light-tech/crazyflie1-electronics/ecad/Crazyflie contol board.kicad_sch

## KiCad design ecad/Crazyflie contol board.kicad_sch (2025-04-17)

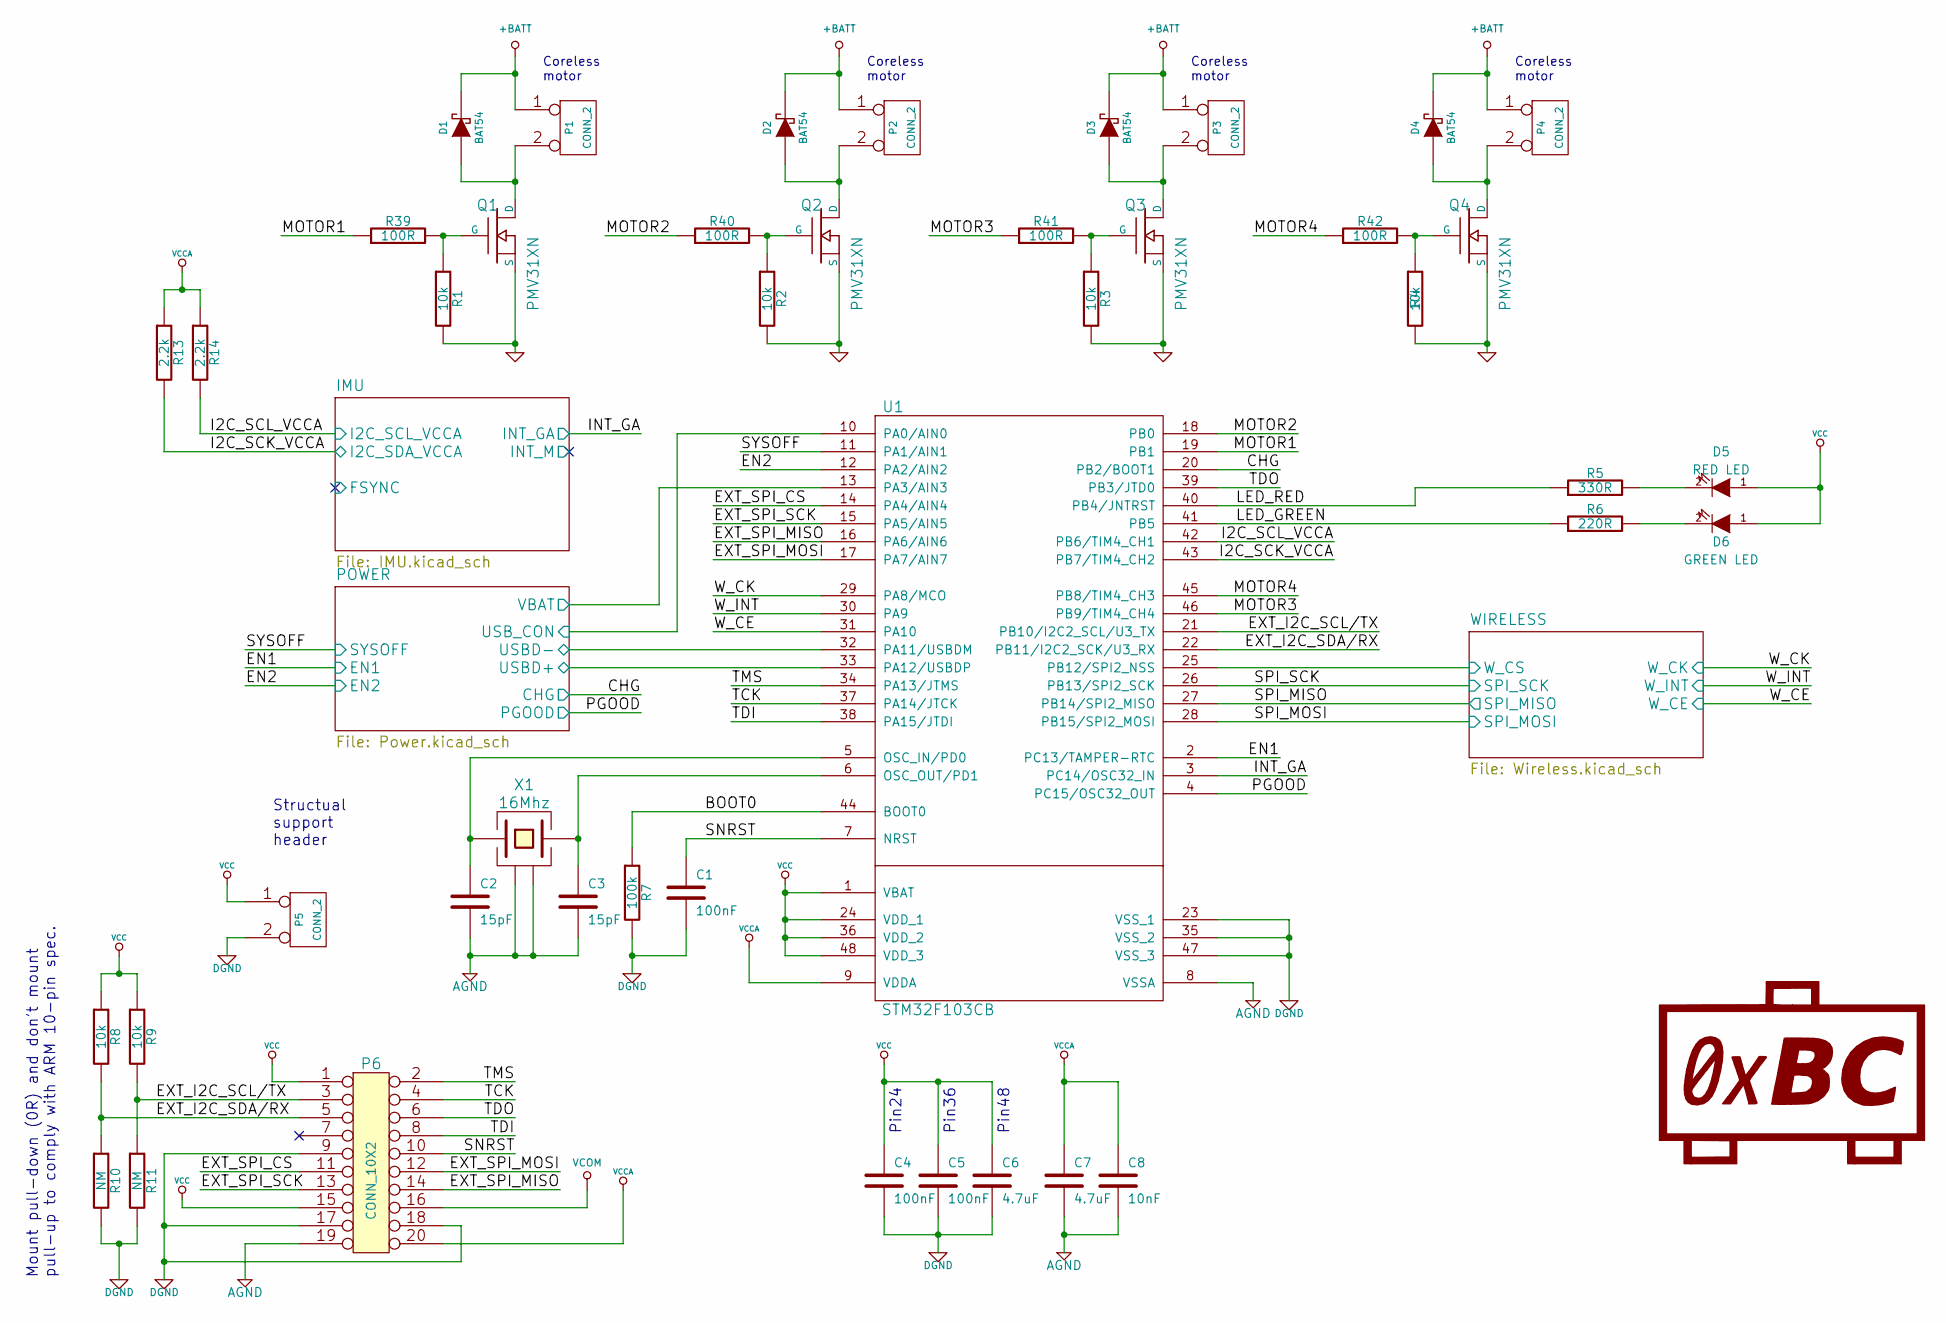
[picture p1: schematic Crazyflie contol board.kicad_sch]

Parts:
C1, C4, C5: 100nF; SM0603_Capa
C2, C3: 15pF; SM0603_Capa
C6, C7: 4.7uF; SM0603_Capa
C8: 10nF; SM0603_Capa
D1, D2, D3, D4: BAT54; SOD323
D5: RED LED; SMDLED-0603
D6: GREEN LED; SMDLED-0603
P1, P2, P3, P4, P5: CONN_2; PINHEADER_127_2X1
P6: CONN_10X2; PINHEADER_127_2X10
Q1, Q2, Q3, Q4: PMV31XN; SOT23GDS
R1, R2, R3, R4: 10k; SM0402
R5: 330R; SM0603
R6: 220R; SM0603
R7: 100k; SM0603
R8, R9: 10k; SM0603
R10, R11: NM; SM0603
R13, R14: 2.2k; SM0603
R39, R40, R41, R42: 100R; SM0402
U1: STM32F103CB; LQFP-48
X1: 16Mhz; XTAL-5.0x3.2

Connections:
+BATT: D1.2 (K), D2.2 (K), D3.2 (K), D4.2 (K), P1.1, P2.1, P3.1, P4.1
AGND: C2.2, C3.2, C7.2, C8.2, P6.19, U1.8 (VSSA), X1.2 (GND), X1.4 (GND)
BOOT0: R7.1, U1.44 (BOOT0)
CHG: U1.20 (PB2/BOOT1)
DGND: C1.2, C4.2, C5.2, C6.2, P5.2 (PM), P6.9, P6.17, P6.18, R7.2, R10.2, R11.2, U1.23 (VSS_1), U1.35 (VSS_2), U1.47 (VSS_3)
EN1: U1.2 (PC13/TAMPER-RTC)
EN2: U1.12 (PA2/AIN2)
EXT_I2C_SCL/TX: P6.3, R9.2, R11.1, U1.21 (PB10/I2C2_SCL/U3_TX)
EXT_I2C_SDA/RX: P6.5, R8.2, R10.1, U1.22 (PB11/I2C2_SCK/U3_RX)
EXT_SPI_CS: P6.11, U1.14 (PA4/AIN4)
EXT_SPI_MISO: P6.14, U1.16 (PA6/AIN6)
EXT_SPI_MOSI: P6.12, U1.17 (PA7/AIN7)
EXT_SPI_SCK: P6.13, U1.15 (PA5/AIN5)
GND: Q1.S, Q2.S, Q3.S, Q4.S, R1.2, R2.2, R3.2, R4.2
I2C_SCK_VCCA: R13.2, U1.43 (PB7/TIM4_CH2)
I2C_SCL_VCCA: R14.2, U1.42 (PB6/TIM4_CH1)
INT_GA: U1.3 (PC14/OSC32_IN)
LED_GREEN: R6.1, U1.41 (PB5)
LED_RED: R5.1, U1.40 (PB4/JNTRST)
MOTOR1: R39.1, U1.19 (PB1)
MOTOR2: R40.1, U1.18 (PB0)
MOTOR3: R41.1, U1.46 (PB9/TIM4_CH4)
MOTOR4: R42.1, U1.45 (PB8/TIM4_CH3)
unnamed: C2.1, U1.5 (OSC_IN/PD0), X1.1
unnamed: C3.1, U1.6 (OSC_OUT/PD1), X1.3
unnamed: D1.1 (A), P1.2 (PM), Q1.D
unnamed: D2.1 (A), P2.2 (PM), Q2.D
unnamed: D3.1 (A), P3.2 (PM), Q3.D
unnamed: D4.1 (A), P4.2 (PM), Q4.D
unnamed: D5.2 (K), R5.2
unnamed: D6.2 (K), R6.2
unnamed: Q1.G, R1.1, R39.2
unnamed: Q2.G, R2.1, R40.2
unnamed: Q3.G, R3.1, R41.2
unnamed: Q4.G, R4.1, R42.2
PGOOD: U1.4 (PC15/OSC32_OUT)
SNRST: C1.1, P6.10, U1.7 (NRST)
SPI_MISO: U1.27 (PB14/SPI2_MISO)
SPI_MOSI: U1.28 (PB15/SPI2_MOSI)
SPI_SCK: U1.26 (PB13/SPI2_SCK)
SYSOFF: U1.11 (PA1/AIN1)
TCK: P6.4, U1.37 (PA14/JTCK)
TDI: P6.8, U1.38 (PA15/JTDI)
TDO: P6.6, U1.39 (PB3/JTD0)
TMS: P6.2, U1.34 (PA13/JTMS)
USBD+: U1.33 (PA12/USBDP)
USBD-: U1.32 (PA11/USBDM)
USB_CON: U1.10 (PA0/AIN0)
VBAT: U1.13 (PA3/AIN3)
VCC: C4.1, C5.1, C6.1, D5.1 (A), D6.1 (A), P5.1, P6.1, P6.15, R8.1, R9.1, U1.1 (VBAT), U1.24 (VDD_1), U1.36 (VDD_2), U1.48 (VDD_3)
VCCA: C7.1, C8.1, P6.20, R13.1, R14.1, U1.9 (VDDA)
VCOM: P6.16
W_CE: U1.31 (PA10)
W_CK: U1.29 (PA8/MCO)
W_CS: U1.25 (PB12/SPI2_NSS)
W_INT: U1.30 (PA9)

Notes on the sheet:
Coreless motor
Pin24
Structual support header
Mount pull-down (0R) and don't mount pull-up to comply with ARM 10-pin spec.
Pin48
Pin36
