light-tech/crazyflie1-electronics/ecad/IMU.kicad_sch

## KiCad design ecad/IMU.kicad_sch (2025-04-17)

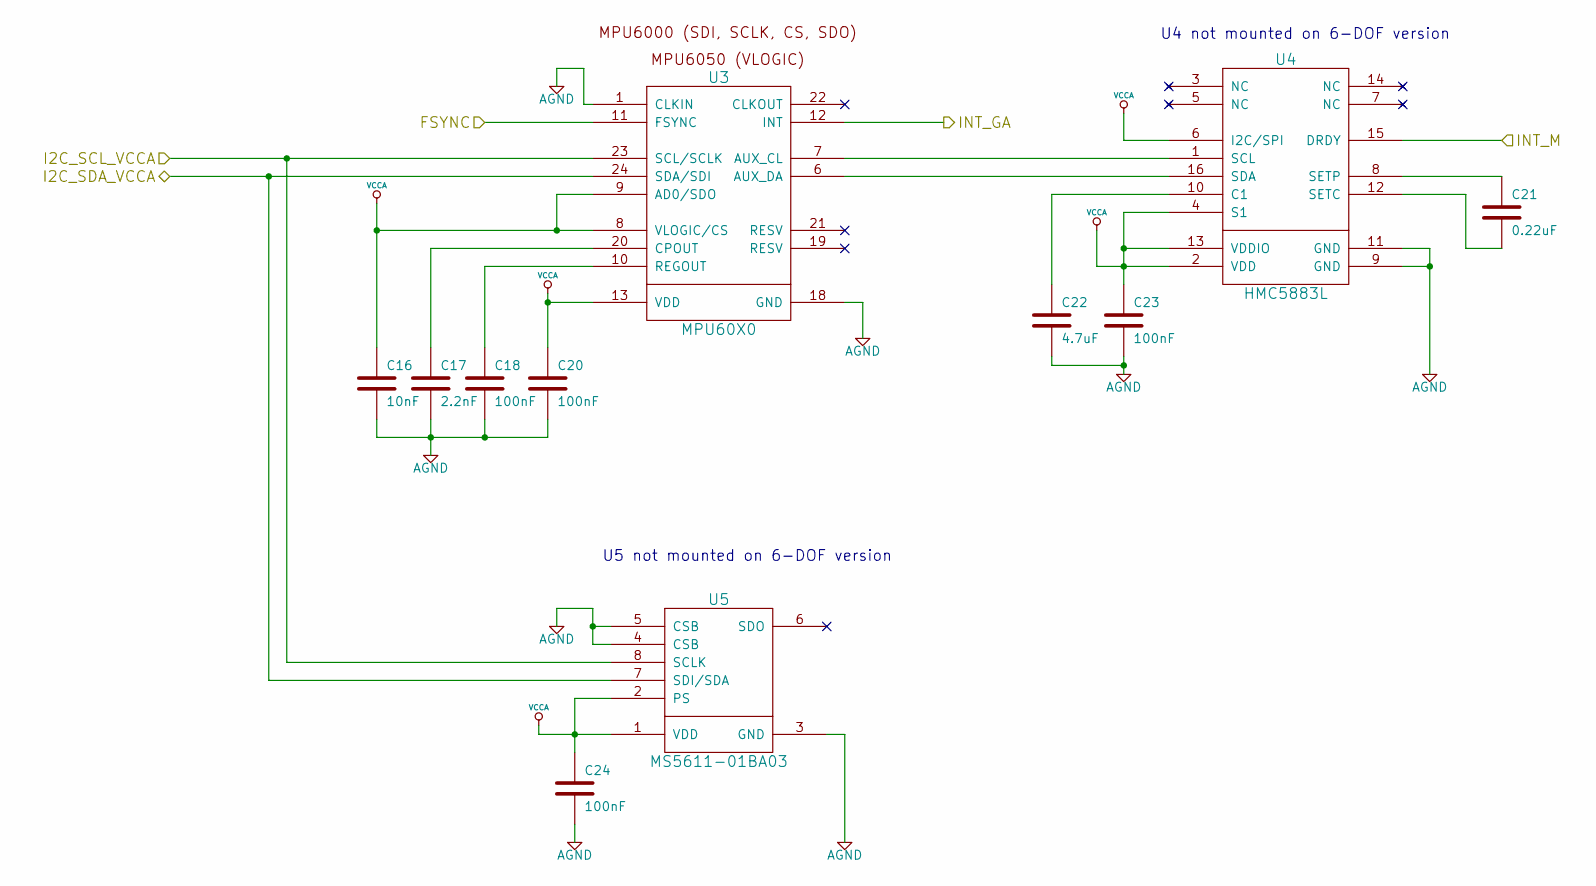
[picture p2: schematic IMU.kicad_sch]

Parts:
C16: 10nF; SM0603_Capa
C17: 2.2nF; SM0603_Capa
C18, C20, C23, C24: 100nF; SM0603_Capa
C21: 0.22uF; SM0603_Capa
C22: 4.7uF; SM0603_Capa
U3: MPU60X0
U4: HMC5883L; QFN16_HMC5883L
U5: MS5611-01BA03; MS5611

Connections:
AGND: C16.2, C17.2, C18.2, C20.2, C22.2, C23.2, C24.2, U3.1 (CLKIN), U3.18 (GND), U4.9 (GND), U4.11 (GND), U5.3 (GND), U5.4 (CSB), U5.5 (CSB)
FSYNC: U3.11 (FSYNC)
I2C_SCL_VCCA: U3.23 (SCL/SCLK), U5.8 (SCLK)
I2C_SDA_VCCA: U3.24 (SDA/SDI), U5.7 (SDI/SDA)
INT_GA: U3.12 (INT)
INT_M: U4.15 (DRDY)
unnamed: C17.1, U3.20 (CPOUT)
unnamed: C18.1, U3.10 (REGOUT)
unnamed: C21.1, U4.8 (SETP)
unnamed: C21.2, U4.12 (SETC)
unnamed: C22.1, U4.10 (C1)
unnamed: U3.6 (AUX_DA), U4.16 (SDA)
unnamed: U3.7 (AUX_CL), U4.1 (SCL)
VCCA: C16.1, C20.1, C23.1, C24.1, U3.8 (VLOGIC/CS), U3.9 (AD0/SDO), U3.13 (VDD), U4.2 (VDD), U4.4 (S1), U4.6 (I2C/SPI), U4.13 (VDDIO), U5.1 (VDD), U5.2 (PS)

Notes on the sheet:
U4 not mounted on 6-DOF version
U5 not mounted on 6-DOF version
