light-tech/crazyflie1-electronics/ecad/Power.kicad_sch

## KiCad design ecad/Power.kicad_sch (2025-04-17)

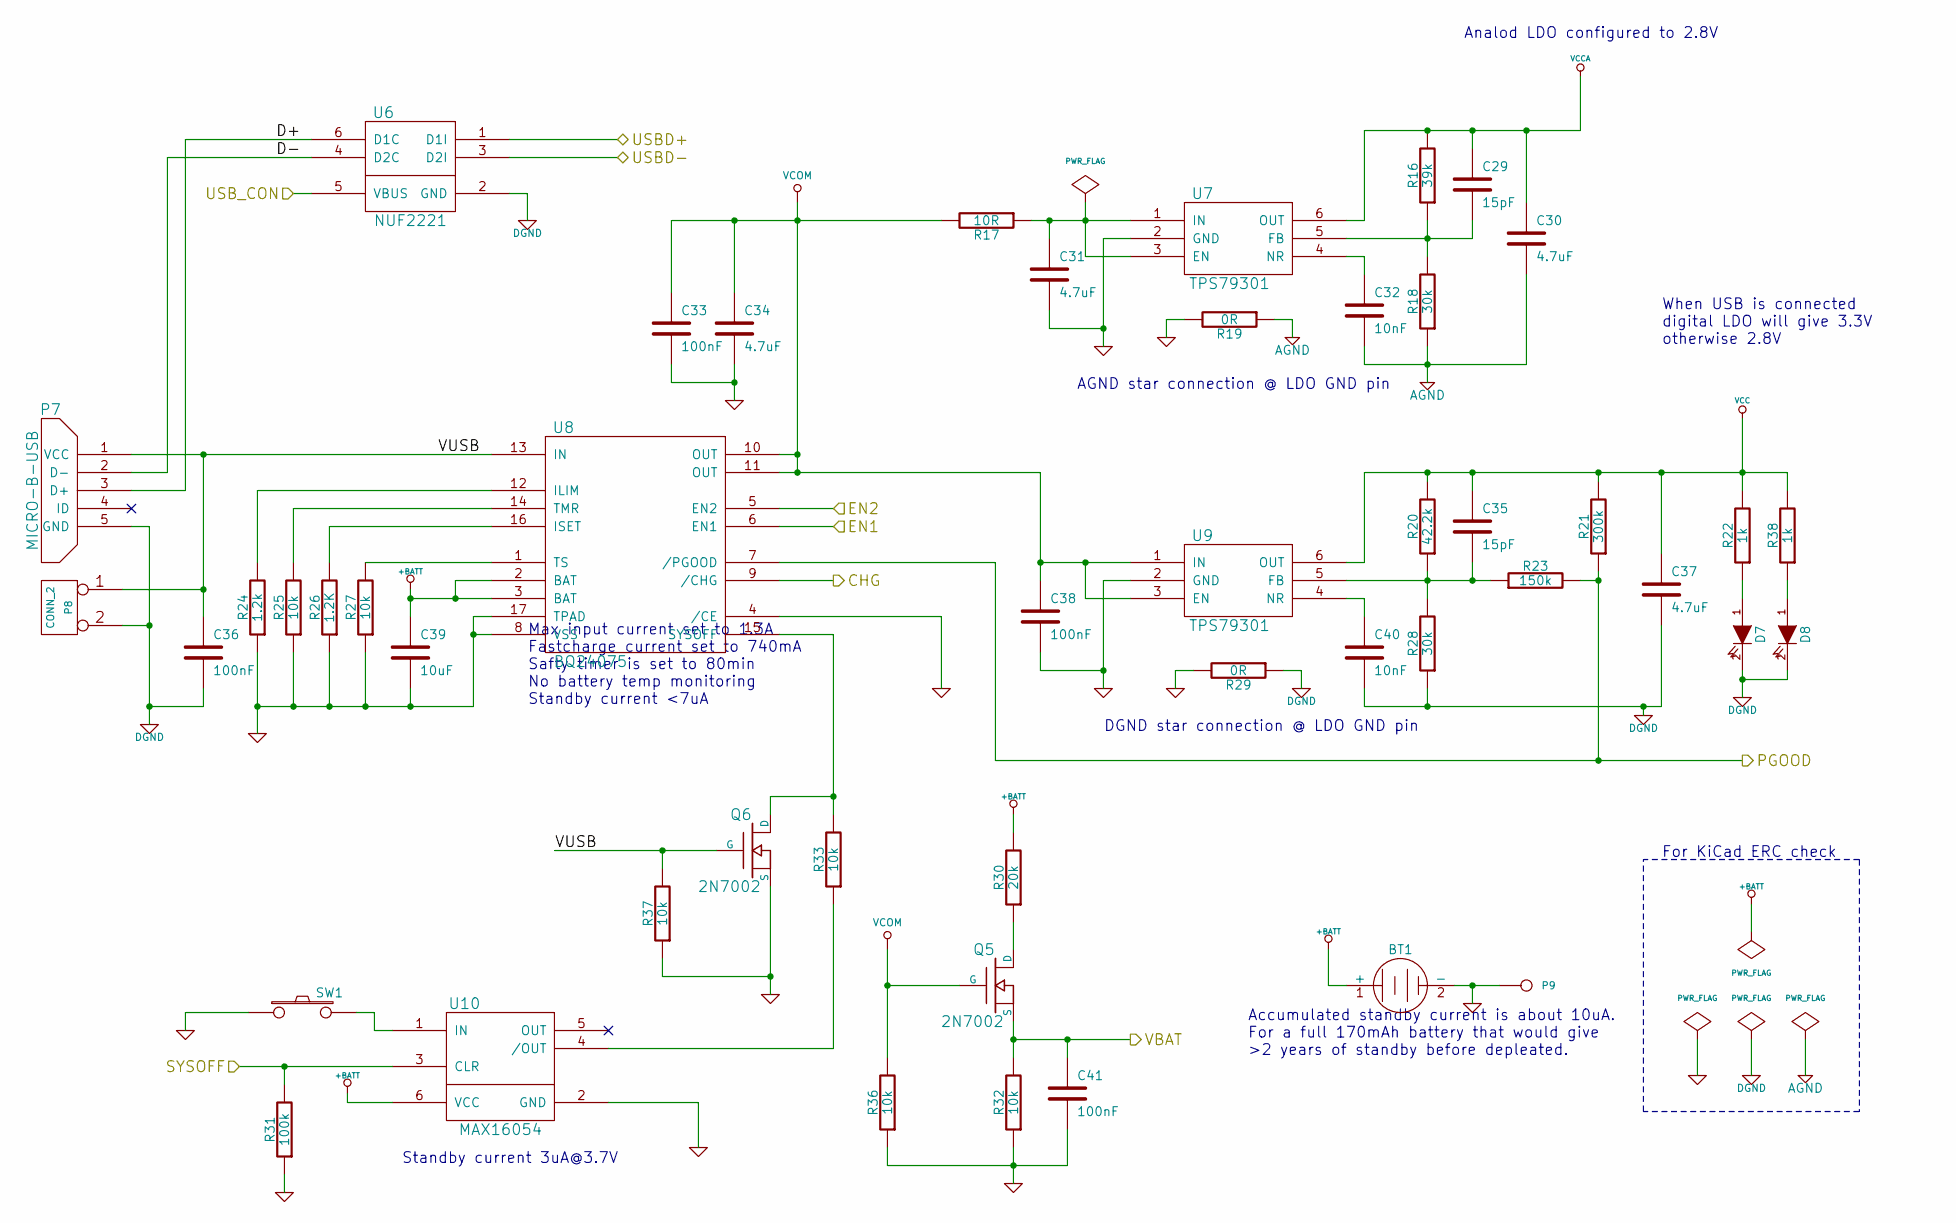
[picture p3: schematic Power.kicad_sch]

Parts:
BT1: BATTERY; JST-B2B-ZR
C29, C35: 15pF; SM0603_Capa
C30, C31, C34, C37: 4.7uF; SM0603_Capa
C32, C40: 10nF; SM0603_Capa
C33, C36, C38, C41: 100nF; SM0603_Capa
C39: 10uF; SM0603_Capa
D7, D8: BLUE LED; SMDLED-0603
P7: MICRO-B-USB; ZX62-B-5PA_11_CFK
P8: CONN_2; PINHEADER_127_2X1
P9: CONN_1; PINHEADER_127_1X1
Q5, Q6: 2N7002; SOT23GDS
R16: 39k; SM0603
R17: 10R; SM0603
R18, R28: 30k; SM0603
R19, R29: 0R; SM0603
R20: 42.2k; SM0603
R21: 300k; SM0603
R22, R38: 1k; SM0603
R23: 150k; SM0603
R24: 1.2k; SM0603
R25, R27, R32, R33, R36, R37: 10k; SM0603
R26: 1.2K; SM0603
R30: 20k; SM0603
R31: 100k; SM0603
SW1: PUSH ON/OFF; SPST-NO-4x2.5
U6: NUF2221; SOT363
U7, U9: TPS79301; SOT23_6
U8: BQ24075; QFN16
U10: MAX16054; SOT23_6

Connections:
+BATT: BT1.1 (+), C39.1, R30.2, U8.2 (BAT), U8.3 (BAT), U10.6 (VCC)
AGND: C30.2, C32.2, R18.1, R19.1
CHG: U8.9 (/CHG)
D+: P7.3 (D+), U6.6 (D1C)
D-: P7.2 (D-), U6.4 (D2C)
DGND: C36.2, C37.2, C40.2, D7.2 (K), D8.2 (K), P7.5 (GND), P8.2 (PM), R28.1, R29.1, U6.2 (GND)
EN1: U8.6 (EN1)
EN2: U8.5 (EN2)
GND: BT1.2 (-), C31.2, C33.2, C34.2, C38.2, C39.2, C41.2, P9.1, Q6.S, R19.2, R24.1, R25.1, R26.1, R27.1, R29.2, R31.1, R32.1, R36.1, R37.1, SW1.1, U7.2 (GND), U8.4 (/CE), U8.8 (VSS), U8.17 (TPAD), U9.2 (GND), U10.2 (GND)
unnamed: C29.2, R16.1, R18.2, U7.5 (FB)
unnamed: C31.1, R17.1, U7.1 (IN), U7.3 (EN)
unnamed: C32.1, U7.4 (NR)
unnamed: C35.2, R20.1, R23.1, R28.2, U9.5 (FB)
unnamed: C40.1, U9.4 (NR)
unnamed: D7.1 (A), R22.1
unnamed: D8.1 (A), R38.1
unnamed: Q5.D, R30.1
unnamed: Q6.D, R33.2, U8.15 (SYSOFF)
unnamed: R24.2, U8.12 (ILIM)
unnamed: R25.2, U8.14 (TMR)
unnamed: R26.2, U8.16 (ISET)
unnamed: R27.2, U8.1 (TS)
unnamed: R33.1, U10.4 (/OUT)
unnamed: SW1.2, U10.1 (IN)
PGOOD: R21.1, R23.2, U8.7 (/PGOOD)
SYSOFF: R31.2, U10.3 (CLR)
USBD+: U6.1 (D1I)
USBD-: U6.3 (D2I)
USB_CON: U6.5 (VBUS)
VBAT: C41.1, Q5.S, R32.2
VCC: C35.1, C37.1, R20.2, R21.2, R22.2, R38.2, U9.6 (OUT)
VCCA: C29.1, C30.1, R16.2, U7.6 (OUT)
VCOM: C33.1, C34.1, C38.1, Q5.G, R17.2, R36.2, U8.10 (OUT), U8.11 (OUT), U9.1 (IN), U9.3 (EN)
VUSB: C36.1, P7.1 (VCC), P8.1, Q6.G, R37.2, U8.13 (IN)

Notes on the sheet:
For KiCad ERC check
Standby current 3uA@3.7V
Accumulated standby current is about 10uA. For a full 170mAh battery that would give >2 years of standby before depleated.
When USB is connected digital LDO will give 3.3V otherwise 2.8V
DGND star connection @ LDO GND pin
Max input current set to 1.3A Fastcharge current set to 740mA Safty timer is set to 80min No battery temp monitoring Standby current <7uA
Analod LDO configured to 2.8V
AGND star connection @ LDO GND pin
