light-tech/crazyflie1-electronics/ecad/Wireless.kicad_sch

## KiCad design ecad/Wireless.kicad_sch (2025-04-17)

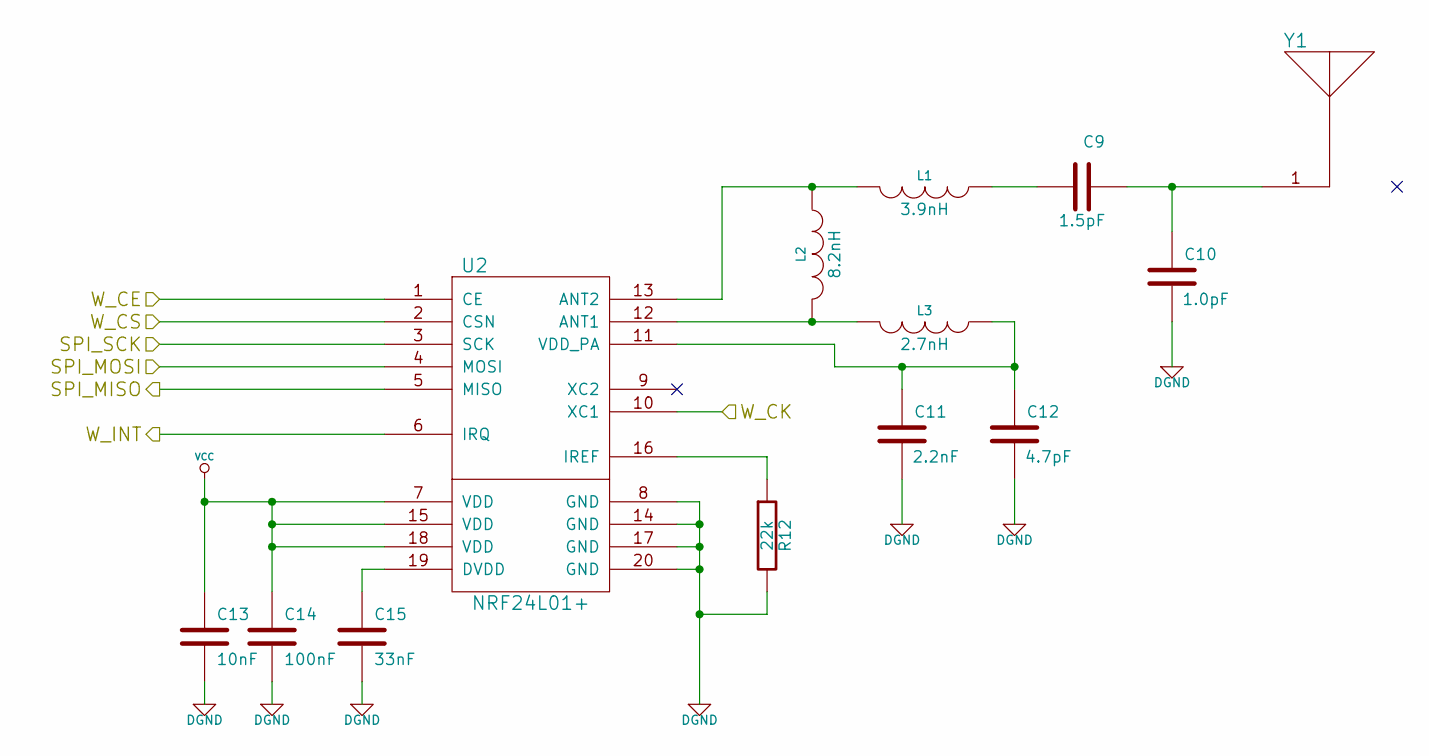
[picture p4: schematic Wireless.kicad_sch]

Parts:
C9: 1.5pF; SM0603_Capa
C10: 1.0pF; SM0603_Capa
C11: 2.2nF; SM0603_Capa
C12: 4.7pF; SM0603_Capa
C13: 10nF; SM0603_Capa
C14: 100nF; SM0603_Capa
C15: 33nF; SM0603_Capa
L1: 3.9nH; SM0603_Capa
L2: 8.2nH; SM0603_Capa
L3: 2.7nH; SM0603_Capa
R12: 22k; SM0603
U2: NRF24L01+; QFN20-4x4mm
Y1: CHIP_ANTENNA; CHIP-ANT-6.5x2.2

Connections:
DGND: C10.2, C11.2, C12.2, C13.2, C14.2, C15.2, R12.2, U2.8 (GND), U2.14 (GND), U2.17 (GND), U2.20 (GND)
unnamed: C9.2, L1.1
unnamed: C9.1, C10.1, Y1.1
unnamed: C11.1, C12.1, L3.1, U2.11 (VDD_PA)
unnamed: C15.1, U2.19 (DVDD)
unnamed: L1.2, L2.1, U2.13 (ANT2)
unnamed: L2.2, L3.2, U2.12 (ANT1)
unnamed: R12.1, U2.16 (IREF)
SPI_MISO: U2.5 (MISO)
SPI_MOSI: U2.4 (MOSI)
SPI_SCK: U2.3 (SCK)
VCC: C13.1, C14.1, U2.7 (VDD), U2.15 (VDD), U2.18 (VDD)
W_CE: U2.1 (CE)
W_CK: U2.10 (XC1)
W_CS: U2.2 (CSN)
W_INT: U2.6 (IRQ)
