light-tech/crazyflie1-electronics/(notices)

Notices in the files:
ecad/IMU.kicad_sch:
Bitcraze AB (CC BY-NC-SA)
